pierrelachevre18/Love_Socks/Word Files/ME210 First Team Meeting.docx

# ME210 Team Meetings

# 02/19/2018:

Set the agenda for :

- Play game
- Four ideas
- Presentation
- Scheduling
- Inventory

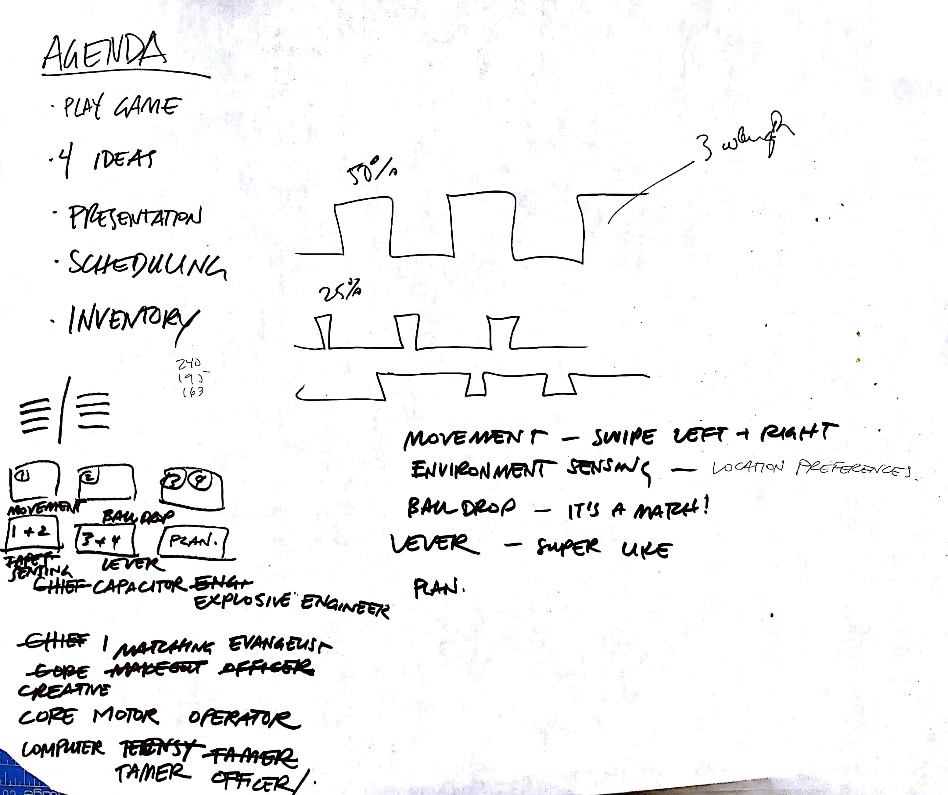
[picture p1: figure]

Played the game with human robots to figure out the details of the rules and figure out some of the best strategy. Questions left to answer: can we leave pieces of the robot on the field? What does the push button looks like? Figured out that moving side ways (crab walk) was more efficient time wise.

Presented the different ideas for the robot. Lever adopted, questioning about the torque needed.

Brainstormed on the ball delivery mechanism: wheel and hole or solenoid gate?

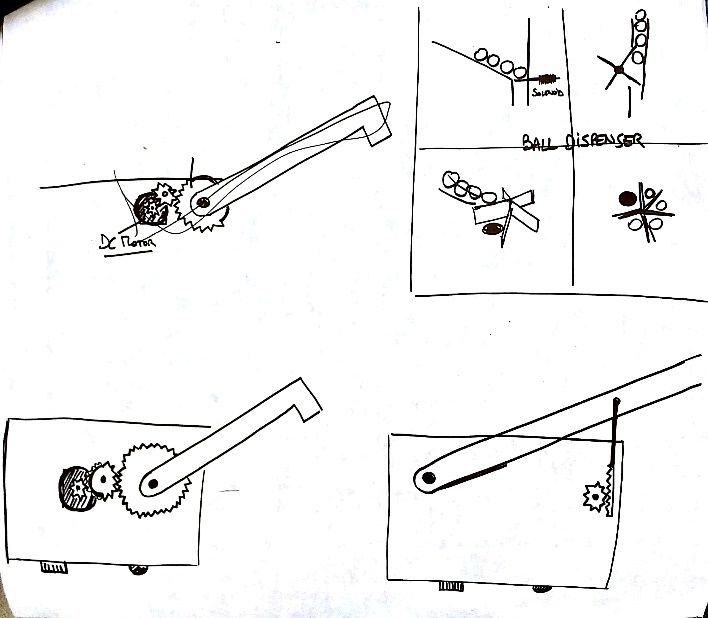
[picture p2: figure]
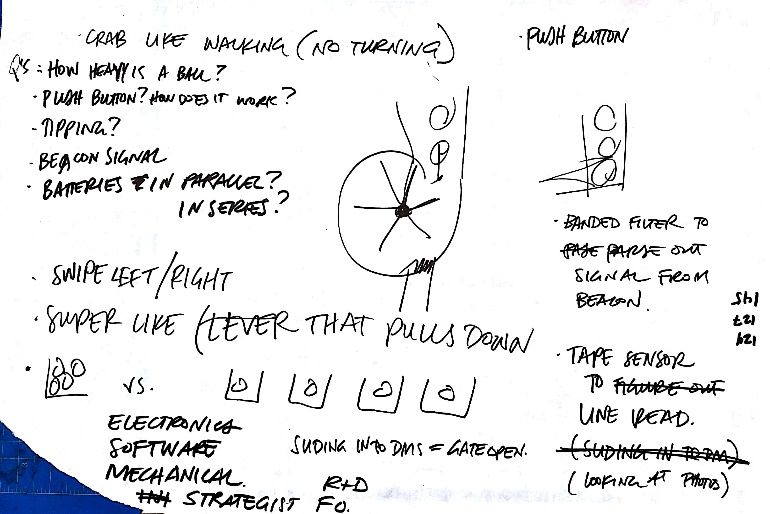
[picture p3: figure]

Talked a little about the wheel disposition plus caster

s

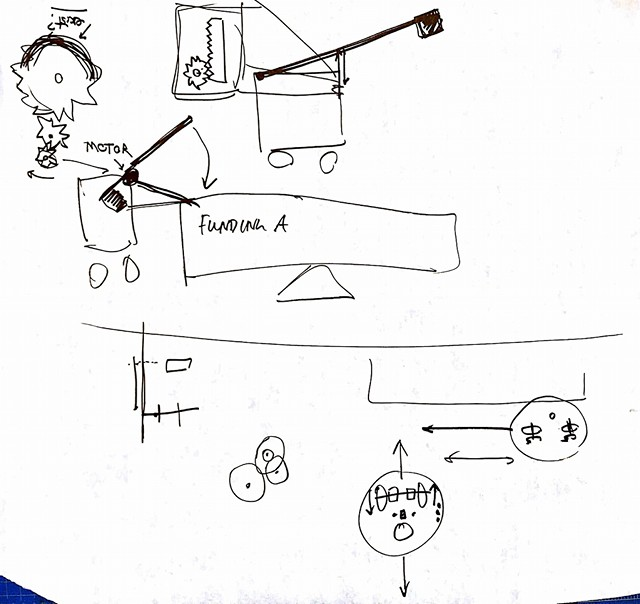
[picture p4: figure]

Sorted out the task, material, sub-task chart

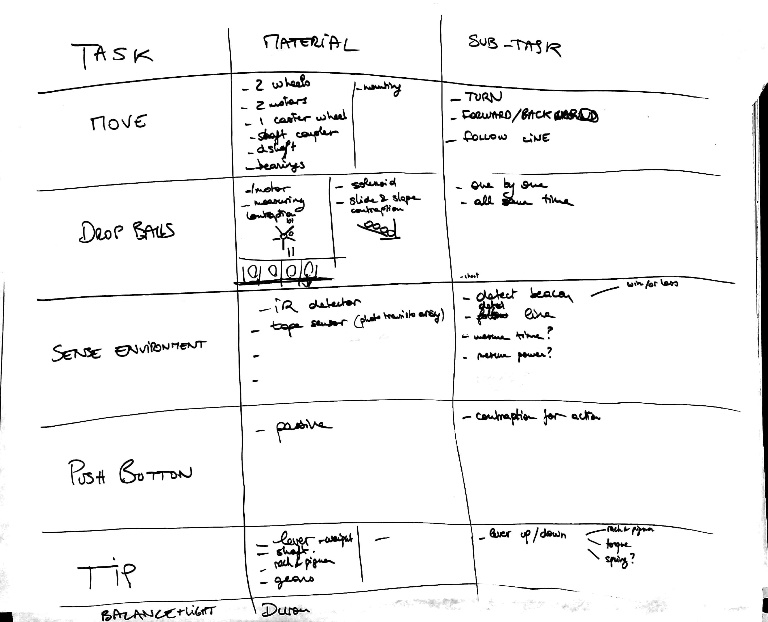
[picture p5: figure]
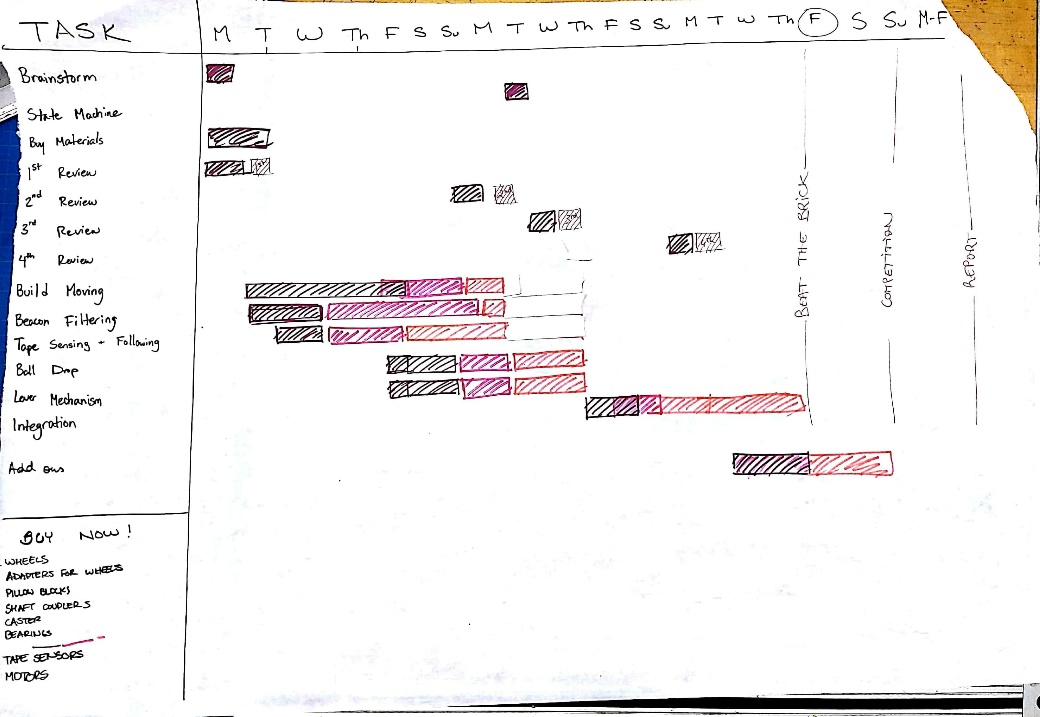
[picture p6: figure]

Worked on the Gantt chart

Worked on the buy list (see material)

https://docs.google.com/spreadsheets/d/1QndJx4MC7VWpCDq9B-suB-2LvONYPwA5EuEKMvLyQ7s/edit#gid=0 (https://l.facebook.com/l.php)

Prepared the slides:

https://docs.google.com/presentation/d/1fEGLEI6NK_dW6Pb4yWJn_U2qOSrptY-A2cQ5sOQAW5k/edit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 (https://l.facebook.com/l.php)

# 02/16/2018:

Set up Github

Set up Logbook

Set up project budget

Minimum meeting every Tuesday after class

Figure out google cal

Give everyone a main responsibility

Figure out a name

Tinder for socks!

Order parts early

For the presentation:

- 4 design concepts
- Gant Diagram
- Chief Title

Line sensing:

First idea for tape sensor circuit:

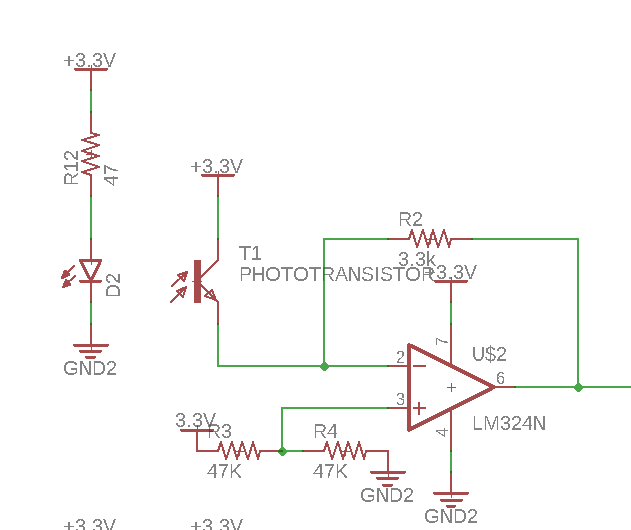
[picture p7: figure]

Didn’t yield big enough difference so went for:

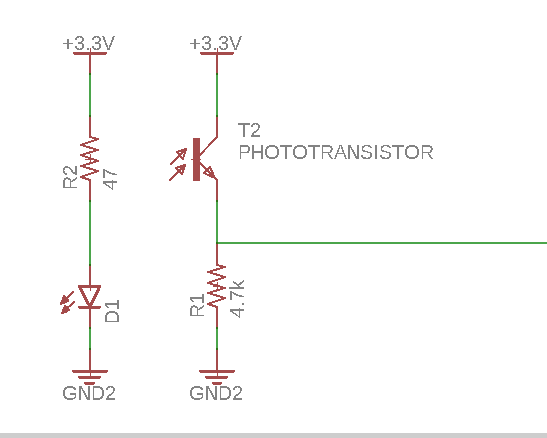
[picture p8: figure]

The test code is :

IntervalTimer printTimer;

int line_swiper =0;

void setup() {

Serial.begin(9600);

printTimer.begin(LinePrint, 500000);

}

void loop() {

line_swiper = analogRead(A0);

}

void LinePrint(void){

Serial.println(line_swiper);

return;

}
