pierrelachevre18/Love_Socks/line_sensing.sch

## EAGLE design line_sensing.sch (2018-03-12)

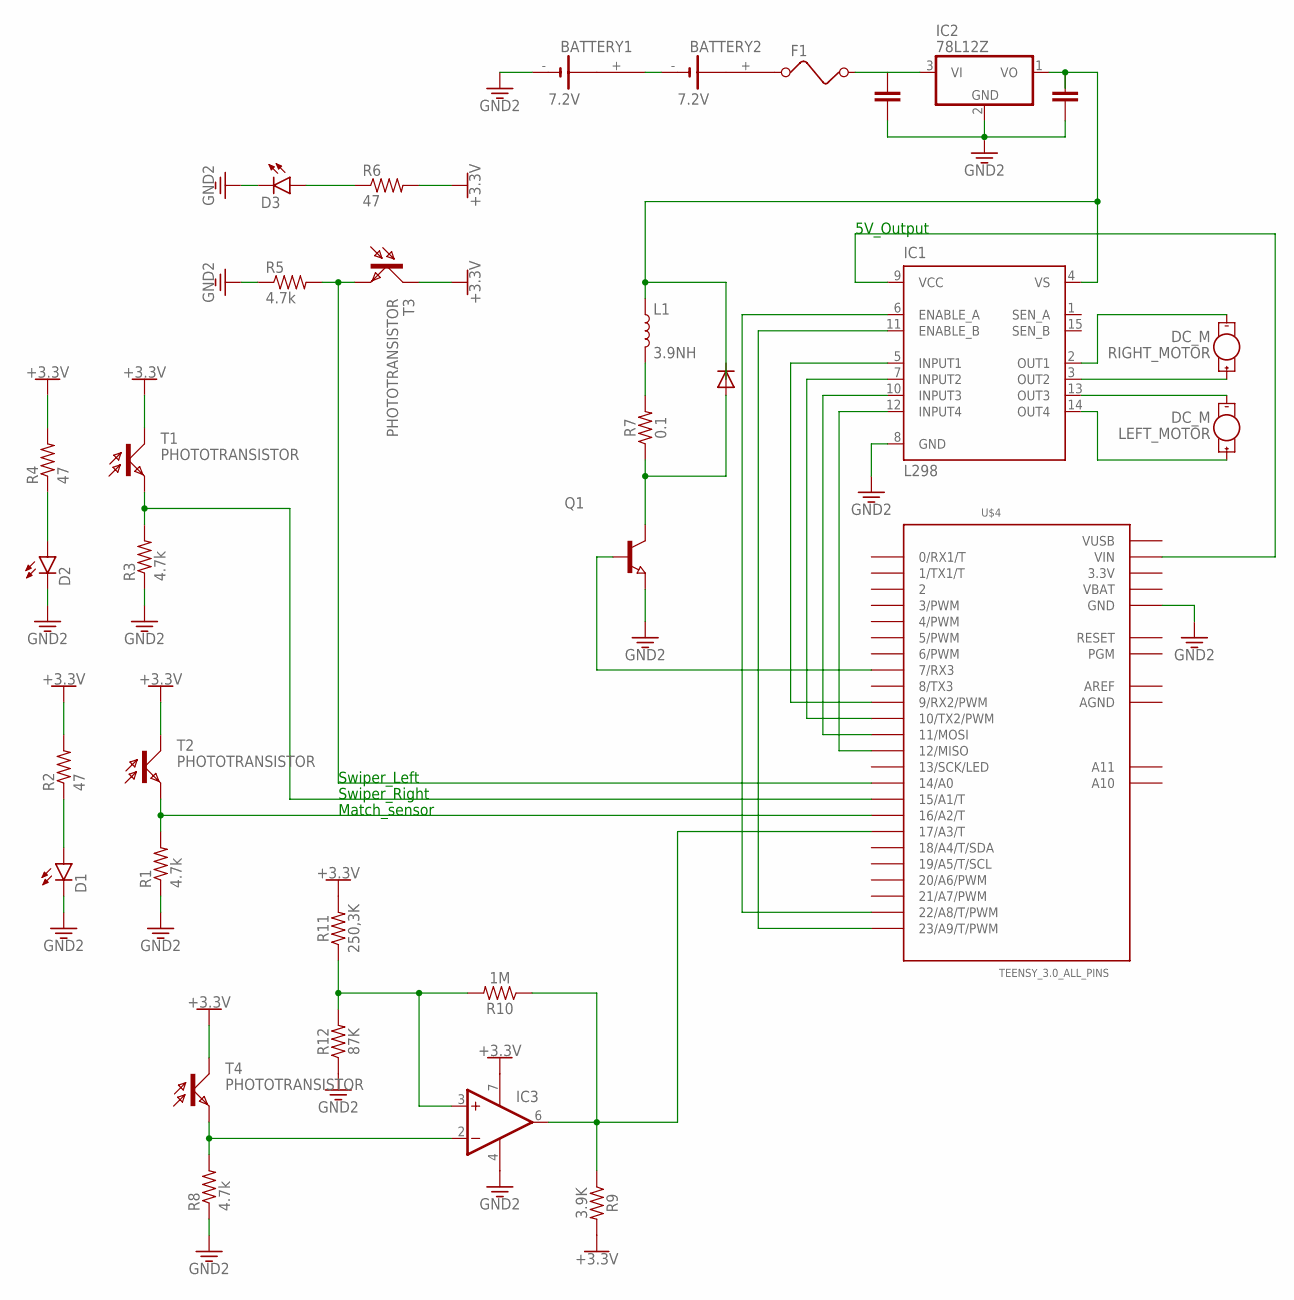
[picture p13: schematic line_sensing.sch]

Parts:
BATTERY1, BATTERY2: 7.2V; B2430UNI
D1, D2, D3: LED-3MM-NO_SILK; LED3MM-NS
F1: FUSE
IC1: L298; MULTIWATT-15
IC2: 78L12Z; TO92
IC3: 1AMP_P7+4D; SO08
L1: 3.9NH; 0402
LEFT_MOTOR: DC_M; VIBE-MOTOR-10MM
Q1: NPN-TRANSISTOR_SOT89; SOT89
R1, R3, R5, R8: 4.7k; 0402-RES
R2, R4, R6: 47; 0402-RES
R7: 0.1; 1210
R9: 3.9K; 1210
R10: 1M; 1210
R11: 250,3K; 1210
R12: 87K; 1210
RIGHT_MOTOR: DC_M; VIBE-MOTOR-10MM
T1, T2, T3, T4: PHOTOTRANSISTOR; BPX81
U$4: TEENSY_3.0_ALL_PINS; TEENSY_3.0-3.2&LC_ALL_PINS

Connections:
3.3V: BATTERY1.-, D1.K (C), D2.K (C), D3.K (C), IC1.8 (GND), IC2.2 (GND), Q1.3 (E), R1.1, R3.1, R5.1, R8.1, R12.1, U$4.GND
5V_OUTPUT: IC1.9 (VCC), U$4.VIN
GND: R2.2, R4.2, R6.2, T1.C, T2.C, T3.C, T4.C
unnamed: D1.A, R2.1
unnamed: R3.2, T1.E, U$4.15/A1 (15/A1/T)
unnamed: D2.A, R4.1
unnamed: IC1.12 (INPUT4), U$4.12 (12/MISO)
unnamed: IC3.6 (OUT), R9.1, R10.1, U$4.17/A3 (17/A3/T)
unnamed: D3.A, R6.1
unnamed: IC1.10 (INPUT3), U$4.11 (11/MOSI)
unnamed: IC1.7 (INPUT2), U$4.10 (10/TX2/PWM)
unnamed: IC1.5 (INPUT1), U$4.9 (9/RX2/PWM)
unnamed: IC1.4 (VS), IC2.1 (VO), L1.1
unnamed: IC1.11 (ENABLE_B), U$4.23/A9 (23/A9/T/PWM)
unnamed: IC1.6 (ENABLE_A), U$4.22/A8 (22/A8/T/PWM)
unnamed: IC1.13 (OUT3), LEFT_MOTOR.-
unnamed: R1.2, T2.E, U$4.16/A2 (16/A2/T)
unnamed: IC1.14 (OUT4), LEFT_MOTOR.+
unnamed: Q1.1 (B), U$4.7 (7/RX3)
unnamed: F1.2, IC2.3 (VI)
unnamed: BATTERY1.+, BATTERY2.-
unnamed: IC1.3 (OUT2), RIGHT_MOTOR.+
unnamed: IC1.2 (OUT1), RIGHT_MOTOR.-
unnamed: L1.2, R7.2
unnamed: Q1.2 (C), R7.1
unnamed: IC3.2 (-IN), R8.2, T4.E
unnamed: R5.2, T3.E, U$4.14/A0
unnamed: BATTERY2.+, F1.1
unnamed: IC3.3 (+IN), R10.2, R11.1, R12.2

Notes on the sheet:
Swiper_Left
Swiper_Right
Match_sensor
5V_Output
