pierrelachevre18/Love_Socks/Eagle Schematics/line_sensing.sch

## EAGLE design Eagle Schematics/line_sensing.sch (2018-02-24)

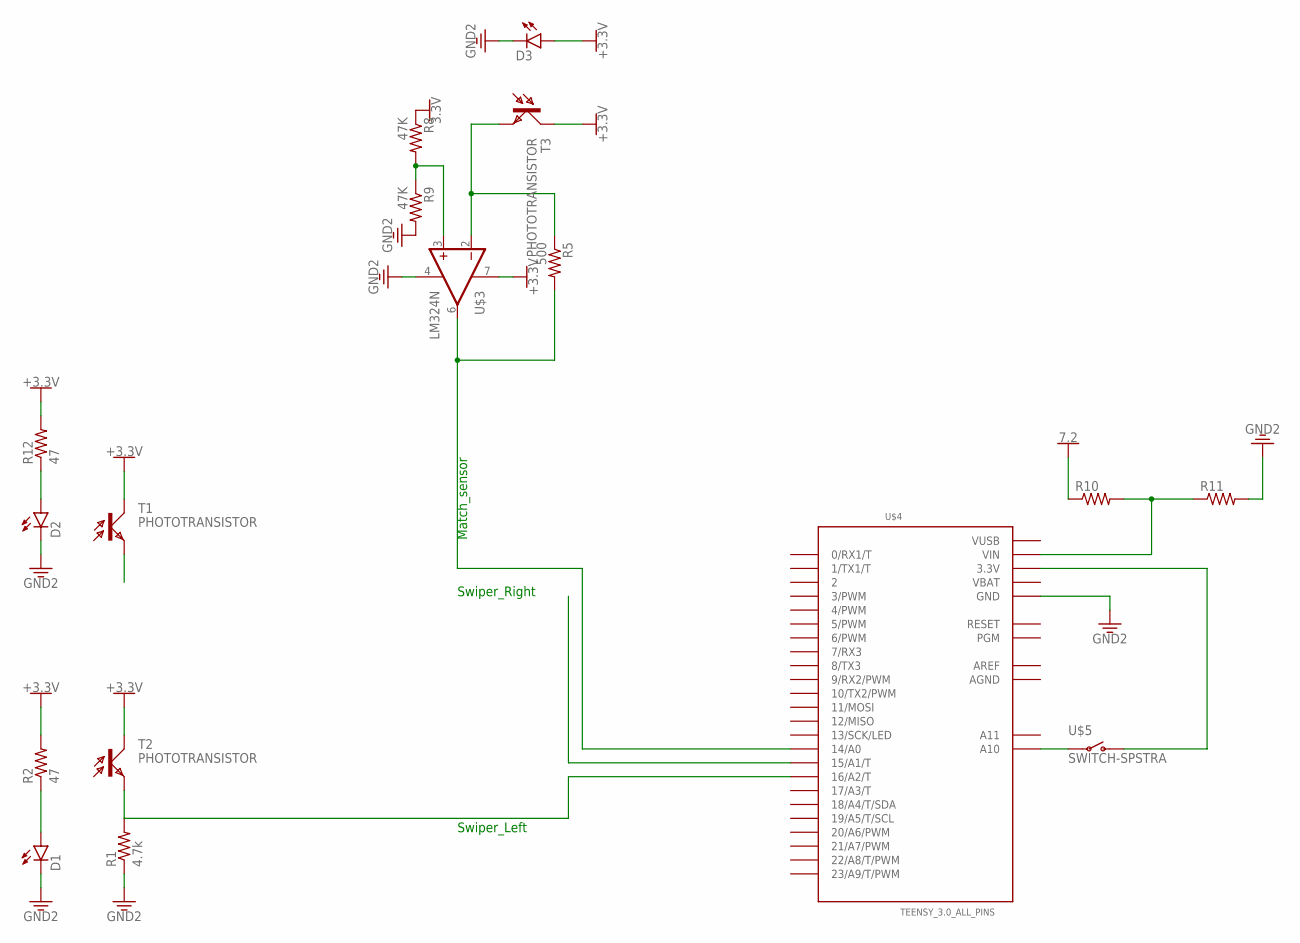
[picture p14: schematic line_sensing.sch]

Parts:
D1, D2, D3: LED-3MM-NO_SILK; LED3MM-NS
R1: 4.7k; 0402-RES
R2, R12: 47; 0402-RES
R5: 500; 0402-RES
R8, R9: 47K; 0402-RES
R10, R11: RESISTOR0402-RES; 0402-RES
T1, T2, T3: PHOTOTRANSISTOR; BPX81
U$3: LM324N; S08FINE
U$4: TEENSY_3.0_ALL_PINS; TEENSY_3.0-3.2&LC_ALL_PINS
U$5: SWITCH-SPSTRA; R_SW_TH

Connections:
3.3V: D1.K (C), D2.K (C), D3.K (C), R1.1, R9.2, R11.2, U$3.4 (V-), U$4.GND
GND: D3.A, R2.2, R8.1, R10.1, R12.2, T1.C, T2.C, T3.C, U$3.7 (V+)
unnamed: D1.A, R2.1
unnamed: R5.1, T3.E, U$3.2 (-IN)
unnamed: R5.2, U$3.6 (OUT), U$4.14/A0
unnamed: R8.2, R9.1, U$3.3 (+IN)
unnamed: R10.2, R11.1, U$4.VIN
unnamed: D2.A, R12.1
unnamed: U$4.A10, U$5.P$4
unnamed: U$4.3.3V, U$5.P$3 (O)
unnamed: T2.E, U$4.16/A2 (16/A2/T)

Notes on the sheet:
Swiper_Left
Swiper_Right
Match_sensor
