pierrelachevre18/Love_Socks/(commit log)

2018-02-22 eagle schematics of the tape sensor
2018-02-23 Code update
    - Finished the code for basic line following, still needs to be tested
    - Rearranged a few files
    [line_sensing.sch]
2018-02-24 case switching validation
2018-02-27 Post testing version
    Succesfully tested motors and basic line following
2018-03-06 solenoid code
2018-03-06 solenoid open close
2018-03-08 added servo control
2018-03-08 Revert "Merge branch 'master' of https://github.com/pierrelachevre18/Love_Socks"
    This reverts commit 400fa64ef1771302c0acd200159b5eb4b53eb922, reversing
    changes made to 83fa36d7b1ac857ef1c5af7c1ef8b9fe7fb4241e.
    [Love_Socks_AI.ino]
2018-03-08 sauvegarde servo
2018-03-08 Merged Servo and Turn codes
    Correct code is now v2
    [Love_Socks_AI_V2.ino]
